Virtex7/APRS-Tracker/README.md

# APRS-Tracker
APRS-Sender in Leichtbauweise für Modellflieger oder Modellfahrzeuge

#3 Achtung:
Dieses Projekt verwendet das Repo "PhilippsKicadBauteile". Dieses muss auf gleicher Ebene wie das APRS-Tracker-Repository abgelegt sein, damit KiCAD es die Bauteile und Footprints finden kann.
