Virtex7/APRS-Tracker/Hardware/Ausgangsfilter.asc

C1: cap; 30pF; V=50
C2: cap; 30pF; V=50
L1: ind; 56nH; Ipk=1 Rser=0.095
L2: ind; 56nH; Ipk=1 Rser=0.095
L3: ind; 100nH; Ipk=1 Rser=0.16
R1: res; 50
V1: voltage; ""; AC 1 0
Named nets: 0
.ac dec 10000 100Meg 0.5G
