Virtex7/APRS-Tracker/Software/usart.h

#ifndef USART_H_
#define USART_H_
#include <libopencm3/stm32/rcc.h>
#include <libopencm3/stm32/usart.h>
// #include <stdio.h>
// #include <ctype.h>
// int _read(int fd, char *ptr, int len);
// int _write(int fd, char *ptr, int len);
// void get_buffered_line(void);
// void back_up(void);
int comm_test(void);
char comm_get(void);
void comm_put(char d);
void comm_puts(const char* s);
void usart_setup(void);
void usart_clock_setup(void);

#endif //--USART_H_
