Virtex7/APRS-Tracker/(commit log)

2015-07-02 dateien dazugefügt - initial commit
    [file55955BF9.sch, stm32 APRS Tracker.sch]
2015-07-02 relativen Pfad für kicad libs versucht
2015-07-02 schaltplan weiter
    [file55955BF9.sch, stm32 APRS Tracker.sch]
2015-07-04 testprogramm für den STM32 geschrieben, das schon mal das LCD ansteuern kann.
2015-07-10 es ist wohl ein größerer stm32 nötig. mit mehr pins.
    [file55955BF9.sch, file55A12ABE.sch, stm32 APRS Tracker.sch]
2015-07-12 Relative Pfade für die Libs
2015-07-12 mcu wird immer größer, jetzt wohl F1
2015-07-12 Anpassen der Datenblätter
2015-07-12 Hinzufügen des STM32F103 (Entwurf)
    [stm32 APRS Tracker.sch]
2015-07-12 umbau auf massiv größeren STM fast abgeschlossen.
    [file55955BF9.sch, file55A12ABE.sch, stm32 APRS Tracker.sch]
2015-07-12 neuer stm eingebunden und adcs angeschlossen
    [file55955BF9.sch, file55A12ABE.sch, stm32 APRS Tracker.sch]
2015-07-13 Schaltplan momentan fertig - Netzliste angefangen.
    [file55955BF9.sch, file55A12ABE.sch, stm32 APRS Tracker.sch]
2015-07-17 Platine angefangen - es wird auf jeden Fall eng
    [file55955BF9.sch, file55A12ABE.sch, stm32 APRS Tracker.kicad_pcb, stm32 APRS Tracker.sch]
2015-07-24 Schaltwandler fast fertig
    [file55955BF9.sch, stm32 APRS Tracker.kicad_pcb]
2015-07-26 Layout durchaus weiter, STM fast komplett angeschlossen
    [stm32 APRS Tracker.kicad_pcb, stm32 APRS Tracker.sch]
2015-07-26 platine fast fertig.
    [file55955BF9.sch, file55A12ABE.sch, stm32 APRS Tracker.kicad_pcb, stm32 APRS Tracker.sch]
2015-07-27 Platine bis auf Sicherung fertig
    [file55955BF9.sch, file55A12ABE.sch, stm32 APRS Tracker.kicad_pcb, stm32 APRS Tracker.sch]
2015-08-02 Anpassung des Siebdrucks, USB Buchse rausgeführt
    [stm32 APRS Tracker.kicad_pcb]
